phiphase/dsp_audio_filter/hardware/audio filter.xlsx

Sheet: BOM
Reference | Qty | Value | Supplier | Order code | Price ea. | QTY ordered | Total price | Ordered | Already got | Notes | Datasheet
A1 | 1 | TPS63060 Module | Pi hut | Adafruit Verta | £9.600 | 1 | £9.60 | Yes | No | Ada Fruit Module | https://www.adafruit.com/product/2190
A2 | 1 | RaspberryPi_Pico-2 | Pi hut |  |  |  |  |  | Yes | RPI Pico 2 module | https://datasheets.raspberrypi.com/pico/pico-datasheet.pdf
A3 | 1 | UDA1334A Module | Pi Hut |  |  |  |  |  | Yes | Ada Fruit Module | https://learn.adafruit.com/adafruit-i2s-stereo-decoder-uda1334a/downloads
A4 | 1 | PAM8302A module | Pi Hut |  | £3.800 | 1 | £3.80 | Yes | No | Ada Fruit Module | https://learn.adafruit.com/adafruit-pam8302-mono-2-5w-class-d-audio-amplifier/downloads
A5 | 1 | ADS1015 module | Pi Hut |  |  |  |  |  | Yes | Ada Fruit Module | https://learn.adafruit.com/adafruit-4-channel-adc-breakouts/downloads
BT1 | 1 | 9 V |  |  |  |  |  |  | Yes | Battery clip | ~
C1 | 1 | 10u |  |  |  |  |  |  | Yes |  | ~
C2,C3,C4,C5,C6,C7 | 6 | 1n |  |  |  |  |  |  | Yes |  | ~
D1,D2,D3 | 3 | 1N4001 |  |  |  |  |  |  | Yes |  | http://www.vishay.com/docs/88503/1n4001.pdf
D4,D5,D6 | 3 | LED |  |  |  |  |  |  | Yes | 3mm, 10 mA | ~
D7 | 1 | 1N4148 |  |  |  |  |  |  | Yes |  | https://www.diodes.com/assets/Datasheets/ds30396.pdf
FB1,FB2,FB3,FB4,FB5,FB6 | 6 | FerriteBead | Bowood Electronics | FRB102 | £0.180 | 10 | £1.80 | No | No |  | ~
J1 | 1 | Switchcraft 721A | Mouser | 502-721A | £3.000 | 2 | £6.00 | Yes | No | Chassis mount 5.5mm/2.1mm DC jack | https://www.mouser.co.uk/datasheet/2/393/721A_CD-2943197.pdf
J2, J3, J5 | 3 | Switchcraft 35RAPC2AV | Mouser | 502-35RAPC2AV | £1.850 | 3 | £5.55 | Yes | No | Chassis mount 3.5mm | https://www.mouser.co.uk/datasheet/2/393/35rapc2av_cd-2942933.pdf
J4, J6 | 1 | Switchcraft 35RAPC4BV4 | Mouser | 502-35RAPC4BV4 | £2.850 | 2 | £5.70 | Yes | No | Chassis mount 3.5 mm | https://www.mouser.co.uk/datasheet/2/393/35rapc__v4_cd-2942951.pdf
J7 | 1 | Switchcraft BPJF04AUX | Mouser | 502-BPJF04AUX | £1.730 | 4 | £6.92 | Yes | No | Chassis mount phono socket | https://www.mouser.co.uk/datasheet/2/393/bpjf_x_series_cd-2943146.pdf
J8 | 1 | Conn_01x03_Pin |  |  |  |  |  |  | Yes |  | ~
JP1 | 1 | short to select fc/BW mode |  |  |  |  |  |  | Yes |  | ~
R1,R2,R3,R4,R6,R7,R9,R11 | 8 | 10k |  |  |  |  |  |  | Yes | 0.125 W | ~
RV1,RV2,RV3, RV4 | 3 | 10k | Mouser | 858-P160KNP0QC20B10K (https://www.mouser.co.uk/ProductDetail/858-P091N-FC25BR10K) | £1.370 | 4 | £5.48 | Yes | No | Potentiometer | https://www.mouser.co.uk/datasheet/2/414/P09x-3235531.pdf
R5 | 1 | 560 |  |  |  |  |  |  | Yes |  | ~
R8,R10,R12 | 3 | 330 |  |  |  |  |  |  | Yes |  | ~
R13 | 1 | 100k |  |  |  |  |  |  | Yes
SW1,SW2,SW3,SW4,SW5,SW6 | 6 | SPST Sub-min toggle switch | Mouser | 737-SW-T3-1A-A-A3-S1 | £0.717 | 6 | £4.30 | Yes | No |  | https://www.mouser.co.uk/datasheet/2/4/sw_t3_1a_a_a3_s1_data_sheet-3396620.pdf
TP1,TP2,TP3,TP4,TP5,TP6,TP7,TP8,TP9,TP10,TP11,TP13 | 12 | TestPoint |  |  |  |  |  |  | Yes |  | ~
TR1 | 1 | BS170 | Mouser | 512-BS170 | £0.133 | 10 | £1.33 | Yes | No | TO-92 N-ch Enh. MOSFET | https://www.onsemi.com/products/discrete-power-modules/mosfets/small-signal-mosfets/bs170
TR2,TR3,TR4 | 3 | 2N2222 | Mouser | 637-2N2222A | £0.094 | 50 | £4.70 | Yes | No | TO92 | https://ngspice.sourceforge.io/docs/ngspice-html-manual/manual.xhtml#cha_BJTs
U5 | 1 | LM4040LP-3 | Mouser | 595-LM4040C30ILPR | £0.614 | 1 | £0.61 | Yes | No | TO92 3.0 V Ref. | http://www.ti.com/lit/ds/symlink/lm4040-n.pdf
Misc.
Veroboard | 1 |  |  |  |  |  |  |  | Yes
9 V PP3 Battery | 1 |  |  |  |  |  |  |  | Yes
Velcro coins for battery | 1 |  |  |  |  |  |  |  | No
Enclosure | 1 |  |  |  |  |  |  |  | No
Knobs for pots | 3 |  | Bowood Electronics | NOB160 | £0.500 | 3 | £1.50 | No | No
0.1 in. pin strip | 5 |  |  |  |  |  |  |  | No
Stick-on feet | 4 |  | RS Components | 276-9477 | £0.100 | 12 | £1.20 | Yes | No
6mm round spacer | 4 |  | RS Components | 606-759 | £7.850 | 1 | £7.85 | Yes | No | Pack of 50
M3 bolt | 4
M3 nut | 4
M3 Washer | 4

Sheet: Connections
Pin no. | J1 | J2 | J3 | J4 | J5 | J6 | J7 | J8 | J9 | J10 | J11 | J12
1 | R | KEY_OUT | GND | GND | GND | GND | AUDIO_IN | SPKR+ | 9V | HP_OUT | TUNE_LED_A | PWR_LED_A
2 | R | \TUNE | GND | SPKR_AMP_AUDIO_IN | \SPKR_ENA | KEY_OUT | GND | SPKR- | GND | GND | TUNE_LED_K | PWR_LED_K
3 | GND | R
4 | \FC_BW (GND) | R
5 | R
6 | \FILTER_IN
7 | \ALE_IN
8 | GND
9 | \AN
10 | KEY_IN
11 | DOT
12 | DASH
