phiphase/dsp_audio_filter/hardware/audio filter.kicad_sch

## KiCad design hardware/audio filter.kicad_sch (2025-12-23, an earlier design)

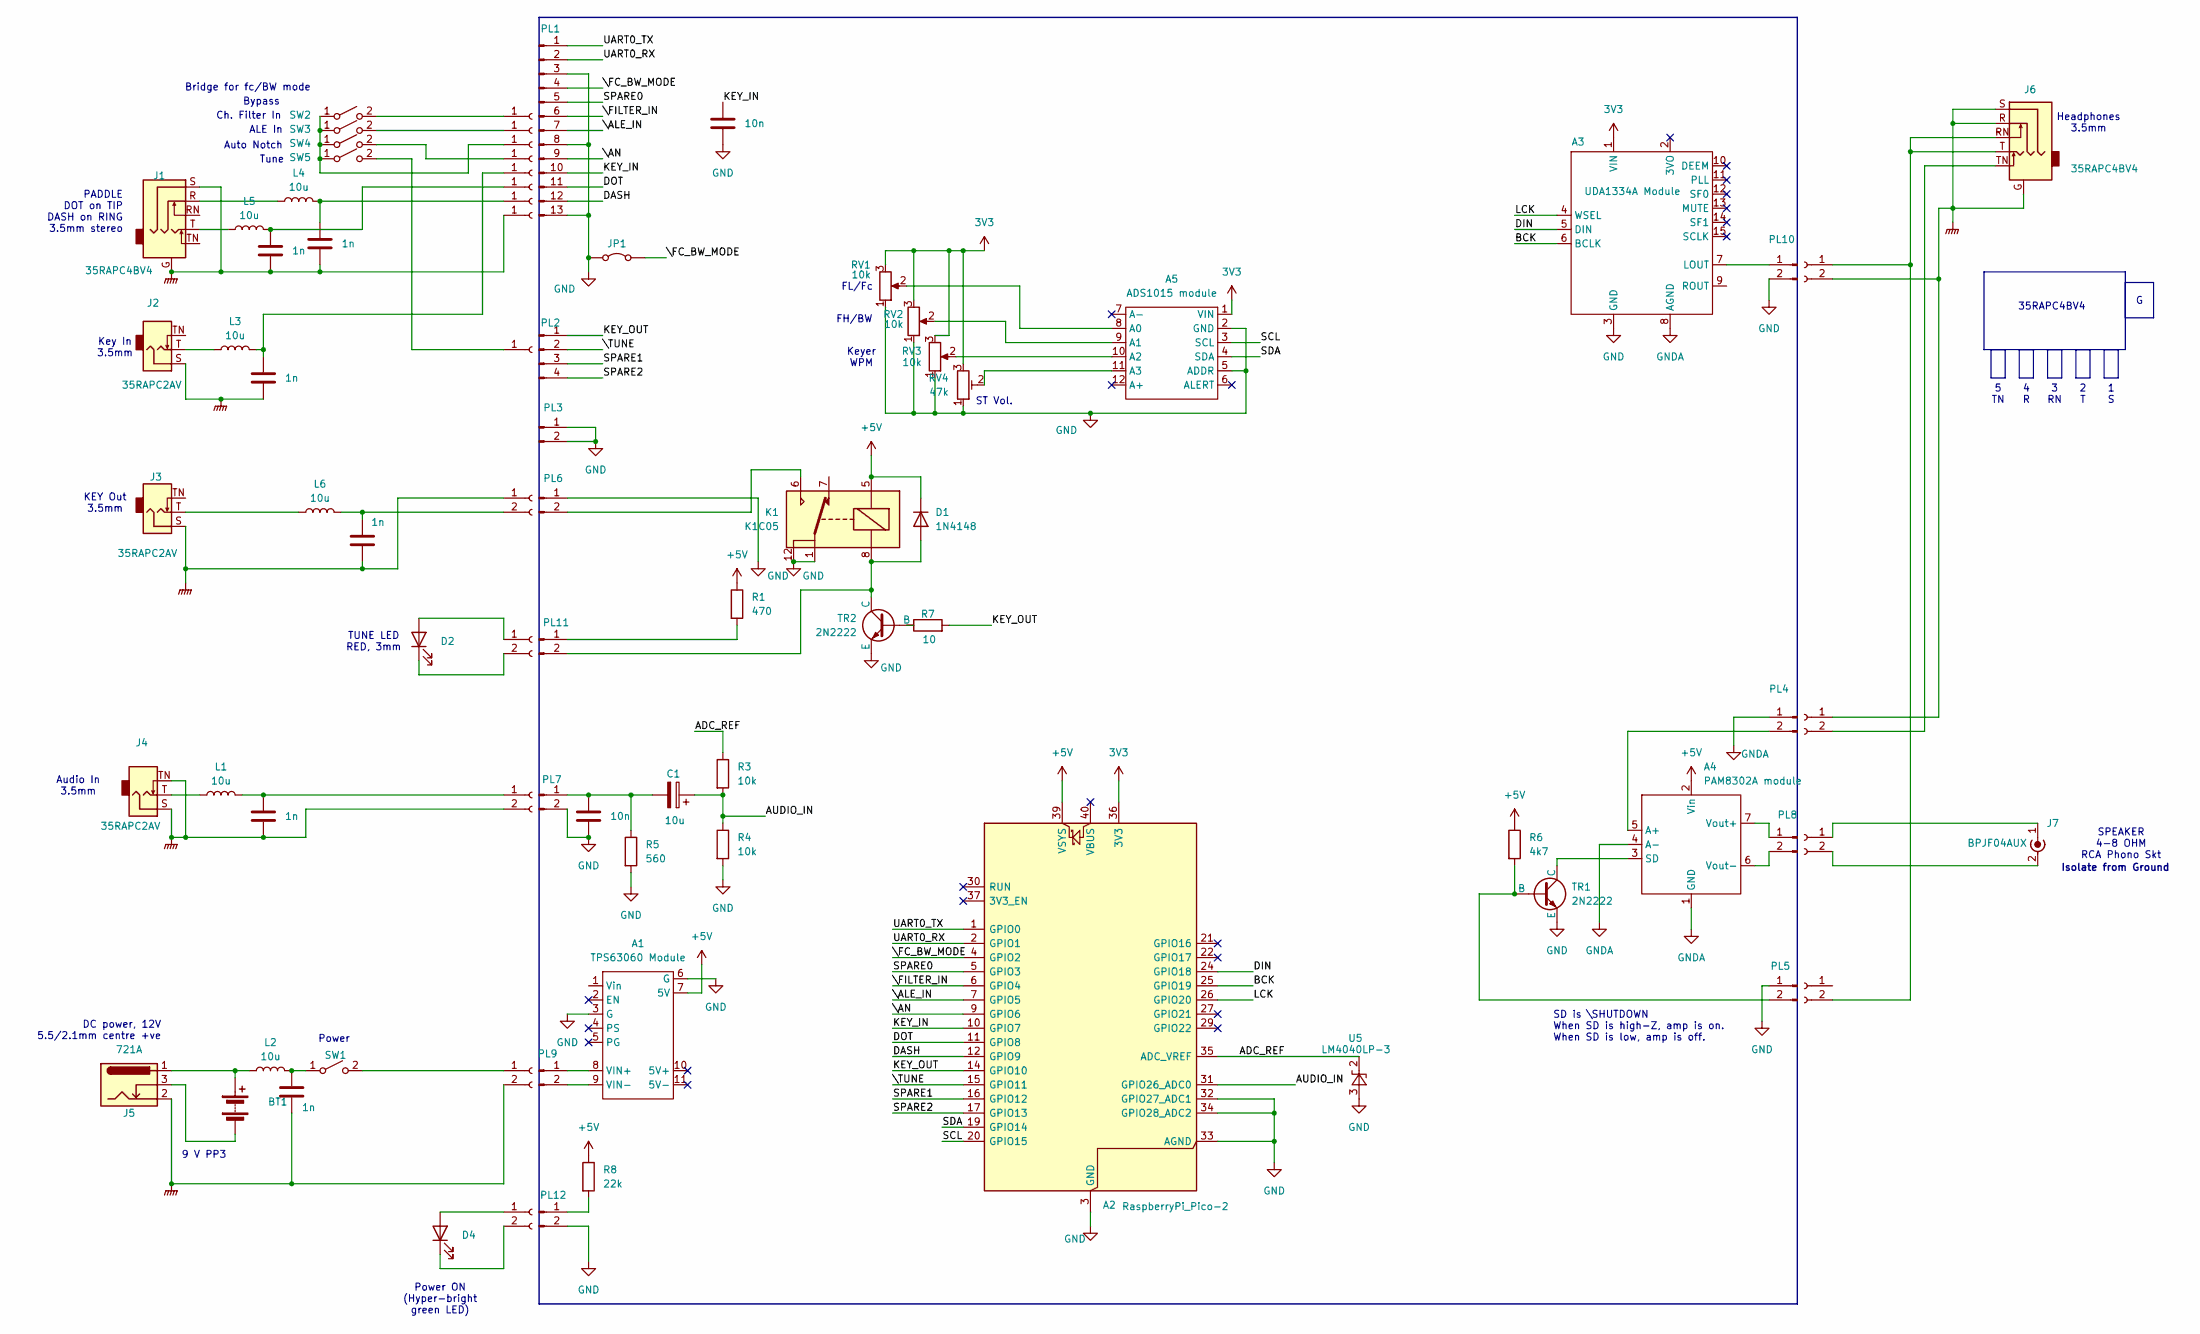
[picture p1: schematic audio filter.kicad_sch]

Parts:
A1: TPS63060 Module
A2: RaspberryPi_Pico-2; RaspberryPi_Pico_Common_Unspecified
A3: UDA1334A Module
A4: PAM8302A module
A5: ADS1015 module
BT1: 9 V
C1: 10u
C2, C3, C4, C5, C6, C7: 1n
C8, C9: 10n
D1: 1N4148; D_SOD-523
D2, D4: LED
J1, J6: 35RAPC4BV4
J2, J3, J4: 35RAPC2AV
J5: 721A
J7: BPJF04AUX
JP1: short to select fc/BW mode
K1: K1C05
L1, L2, L3, L4, L5, L6: 10u
PL1: Conn_01x13_Pin
PL2: Conn_01x04_Pin
PL3, PL4, PL5, PL6, PL7, PL8, PL9, PL10, PL11, PL12: Conn_01x02_Pin
R1: 470
R3, R4: 10k
R5: 560
R6: 4k7
R7: 10
R8: 22k
RV1, RV2, RV3: 10k
RV4: 47k
SK1a1, SK1b1, SK1c1, SK1d1, SK1e1, SK1f1, SK1g1, SK1h1, SK2a1: Conn_01x01_Socket
SK4, SK5, SK6, SK7, SK8, SK9, SK10, SK11, SK12: Conn_01x02_Socket
SW1, SW2, SW3, SW4, SW5: SW-T2-1C-A-A2-M1
TR1, TR2: 2N2222
U5: LM4040LP-3; TO-92_Inline

Connections:
3V3: A2.36 (3V3), A3.1 (VIN), A5.1 (VIN), RV1.3, RV2.3, RV3.3, RV4.3
+5V: A1.7 (5V), A2.39 (VSYS), A4.2 (Vin), D1.1 (K), K1.5, R1.1, R6.1, R8.1
ADC_REF: A2.35 (ADC_VREF), R3.1, U5.2 (K)
AUDIO_IN: A2.31 (GPIO26_ADC0), C1.1, R3.2, R4.1
BCK: A2.25 (GPIO19), A3.6 (BCLK)
DASH: A2.12 (GPIO9), PL1.12
DIN: A2.24 (GPIO18), A3.5 (DIN)
DOT: A2.11 (GPIO8), PL1.11
GND: A1.3 (G), A1.6 (G), A2.3 (GND), A2.8 (GND), A2.13 (GND), A2.18 (GND), A2.23 (GND), A2.28 (GND), A2.32 (GPIO27_ADC1), A2.33 (AGND), A2.34 (GPIO28_ADC2), A2.38 (GND), A3.3 (GND), A5.2 (GND), A5.5 (ADDR), C8.2, C9.2, JP1.1 (A), K1.1, K1.12, PL1.3, PL1.8, PL1.13, PL3.1, PL3.2, PL5.1, PL6.1, PL7.2, PL10.2, PL12.2, R4.2, R5.2, RV1.1, RV2.1, RV3.1, RV4.1, TR1.3 (E), TR2.3 (E), U5.3 (A)
GNDA: A3.8 (AGND), A4.1 (GND), A4.4 (A-), PL4.1
GNDPWR: C2.2, C3.2, C4.2, C5.2, C6.2, C7.2, J1.G, J1.S, J2.S, J3.S, J4.S, J4.TN, J5.2, J6.G, J6.R, J6.S, SK1h1.1, SK4.1, SK6.1, SK7.2, SK9.2, SK10.2
KEY_IN: A2.10 (GPIO7), C9.1, PL1.10
KEY_OUT: A2.14 (GPIO10), PL2.1, R7.2
LCK: A2.26 (GPIO20), A3.4 (WSEL)
unnamed: A1.8 (VIN+), PL9.1
unnamed: A1.9 (VIN-), PL9.2
unnamed: A3.7 (LOUT), PL10.1
unnamed: A4.3 (SD), TR1.1 (C)
unnamed: A4.5 (A+), PL4.2
unnamed: A4.6 (Vout-), PL8.2
unnamed: A4.7 (Vout+), PL8.1
unnamed: A5.8 (A0), RV1.2
unnamed: A5.9 (A1), RV2.2
unnamed: A5.10 (A2), RV3.2
unnamed: A5.11 (A3), RV4.2
unnamed: BT1.1 (+), J5.1, L2.1
unnamed: BT1.2 (-), J5.3
unnamed: C1.2, C8.1, PL7.1, R5.1
unnamed: C2.1, L2.2, SW1.1 (A)
unnamed: C3.1, L1.2, SK7.1
unnamed: C4.1, L3.2, SK1e1.1
unnamed: C5.1, L4.2, SK1g1.1
unnamed: C6.1, L5.2, SK1f1.1
unnamed: C7.1, L6.2, SK6.2
unnamed: D1.2 (A), K1.8, PL11.2, TR2.1 (C)
unnamed: D2.1 (K), SK11.2
unnamed: D2.2 (A), SK11.1
unnamed: D4.1 (K), SK12.2
unnamed: D4.2 (A), SK12.1
unnamed: J1.R, L4.1
unnamed: J1.T, L5.1
unnamed: J2.T, L3.1
unnamed: J3.T, L6.1
unnamed: J4.T, L1.1
unnamed: J6.RN, J6.T, SK5.2, SK10.1
unnamed: J6.TN, SK4.2
unnamed: J7.1 (In), SK8.1
unnamed: J7.2 (Ext), SK8.2
unnamed: K1.6, PL6.2
unnamed: PL5.2, R6.2, TR1.2 (B)
unnamed: PL11.1, R1.2
unnamed: PL12.1, R8.2
unnamed: R7.1, TR2.2 (B)
unnamed: SK1a1.1, SW2.2 (B)
unnamed: SK1b1.1, SW3.2 (B)
unnamed: SK1c1.1, SW2.1 (A), SW3.1 (A), SW4.1 (A), SW5.1 (A)
unnamed: SK1d1.1, SW4.2 (B)
unnamed: SK2a1.1, SW5.2 (B)
unnamed: SK9.1, SW1.2 (B)
SCL: A2.20 (GPIO15), A5.3 (SCL)
SDA: A2.19 (GPIO14), A5.4 (SDA)
SPARE0: A2.5 (GPIO3), PL1.5
SPARE1: A2.16 (GPIO12), PL2.3
SPARE2: A2.17 (GPIO13), PL2.4
UART0_RX: A2.2 (GPIO1), PL1.2
UART0_TX: A2.1 (GPIO0), PL1.1
\ALE_IN: A2.7 (GPIO5), PL1.7
\AN: A2.9 (GPIO6), PL1.9
\FC_BW_MODE: A2.4 (GPIO2), JP1.2 (B), PL1.4
\FILTER_IN: A2.6 (GPIO4), PL1.6
\TUNE: A2.15 (GPIO11), PL2.2

Notes on the sheet:
9 V PP3
Ch. Filter In
Auto Notch
Isolate from Ground
Bypass
SD is \SHUTDOWN When SD is high-Z, amp is on. When SD is low, amp is off.
Tune
1 S
5 TN
3 RN
SPEAKER 4-8 OHM RCA Phono Skt
FL/Fc
Key In 3.5mm
35RAPC4BV4
KEY Out 3.5mm
TUNE LED RED, 3mm
Bridge for fc/BW mode
PADDLE DOT on TIP DASH on RING 3.5mm stereo
ALE In
Keyer WPM
4 R
Audio In 3.5mm
Headphones 3.5mm
ST Vol.
FH/BW
Power
2 T
DC power, 12V 5.5/2.1mm centre +ve
Power ON (Hyper-bright green LED)
