phiphase/dsp_audio_filter/software/cw.h

/*
  ******************************************************************************
  * Copyright (C) 2025 Adrian P. Nash, G4ZHZ, github/phiphase
  * File:    cw.h
  * Description:
  * Definitions for the CW/side-tone functions
  *****************************************************************************
  */
 #ifndef __CW_H__
 #define __CW_H__

#include "arm_math.h"
#include <math.h>
#ifndef M_PI
#define M_PI 3.1415926535897932384626433832
#endif

#define Q15

#ifdef Q15
#define NUM_CW_FILTER_COEFFS 6
typedef struct
{
  float32_t dphi; // delta-phi to provide the side-tone frequency
  uint64_t n;     // The sample number
  arm_biquad_casd_df1_inst_q15 filterObj;
  q15_t coeffs[NUM_CW_FILTER_COEFFS];
  q15_t state[4];
} cw_gen_obj;


void init_cw(cw_gen_obj *obj, float32_t fs, float32_t fst);
void gen_cw(cw_gen_obj *obj, q15_t * input, q15_t *output, float32_t amp, uint32_t numSamples);

#else
#define NUM_CW_FILTER_COEFFS 5
typedef struct
{
  float32_t dphi; // delta-phi to provide the side-tone frequency
  uint64_t n;     // The sample number
  arm_biquad_casd_df1_inst_f32 filterObj;
  float32_t coeffs[NUM_CW_FILTER_COEFFS];
  float32_t state[4]; 
} cw_gen_obj;

void init_cw(cw_gen_obj *obj, float32_t fs, float32_t fst);
void gen_cw(cw_gen_obj *obj, q15_t * input, q15_t *output, float32_t amp, uint32_t numSamples);

#endif //Q15

#endif
