phiphase/dsp_audio_filter/(commit log)

2025-07-13 Added I2S DMA to drive the PIO.
2025-07-16 I2S PIO now working via DMA and DMA interrupt handler. Merged hello.c into dsp_audio_filter and hello.pio into i2s.pio.
2025-07-21 ADC and I2S use two DMA channels each to effectively access two buffers so that we can do pint-pong buffering. Two DMA ISRs are provided. IRQ0 is for the ADC DMA and IRQ1 is for the I2S DMA.
2025-07-22 Using the ADC interrupt and adc_semaphore, the ping-pong buffer management appears to work.
2025-07-24 Changed the PIO clock division to be fractional using the sm_config_set_clkdiv_int_frac8() function. This enables an exact 8ksps to be used for I2S.
    Changed the ring buffer size from 9 to 8 bits for
    the ADC and 10 to 9 bits for the I2S.
    The ADC output is now left-shifted by 3 bits so
    that it aligns with 16 bit 2's complement.
2025-07-26 Added support for the ARM CMSIS library.
2025-07-26 Added Kaiser window filtering functions to dynamicFilters.c and dynamicFilters.h. Modified dsp_audio_filter.c so that core 1 generates the coefficients so that they can be verified in MATLAB.
2025-07-27 filter.c and filter.h added. The ARM CMSIS-DSP filter has been added to filter the channel. Inter-processor communication added that uses the hardware FIFO to send commands from core-1 to core-0 and 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
2025-08-03 Added the ADS1015 ADC driver functionality.
2025-08-03 ADC now connected to the channel filter so the ADC channel 0 controls the HPF cut-off frequency and ADC channel 1 controls the LPF cut-off frequency.
2025-08-03 Added GPIO2 fc/bw mode set. When GPIO2 is pulled low, fc/bw for ADC 0/1 is set. When GPIO2 is left floating (pulled up), fL/fH for ADC 0/1 is selected.
2025-08-09 ALE now working. Moved all CMSIS filter variables into global space so that the spin-locks work correctly.
    [dsp_audio_filter.c]
2025-08-10 Added the GPIO edge-sensitive interrupt handler and got the profiler option working correctly.
    [dsp_audio_filter.c]
2025-08-13 Got the Imbic electronic keyer working. Added ADC-controlled keyer speed. Added ADC-controlled volume control but need to make this logarithmic.
2025-08-15 Added a volume control on adc[3]. However, this is not needed because we can use the Rx volume control, so it will be removed.
2025-08-15 Added a type I Bi-quad IIR filter to cw generator.
2025-09-28 Added the KiCad hardware files
    [audio filter.csv, audio filter.kicad_pcb, audio filter.kicad_sch, audio filter.xlsx]
2025-09-28 Updated from audio filter bom v2
    [audio filter.xlsx]
2025-10-04 Changed B_MIN and B_MAX to 0 Hz and 2000 Hz repectively. Changed FC_MIN and FC_MAX to 0 Hz and 2000 Hz respectively.
2025-10-04 DSP Audio Filter artwork for Gekko rub-down Deccal paper. Print the User-2 layer.
    [panel-art.kicad_pcb]
2025-10-04 DSP Audio Filter front and rear panel drawings. Use as a template for drilling the panels. paper. Print the User-drawings, User-3 and User-4 layers.
    [panel-drg.kicad_pcb]
2025-10-04 Moved the KEY LED position.
    [panel-drg.kicad_pcb]
2025-10-04 Moved the location of the KEY LED text. Changed radius of knobs to 5.5mm.
    [panel-art.kicad_pcb]
2025-10-14 Version 0.3 RE-arranged circuit into external connections and on-board headers. Changed FBs to 10uH inductors.
    [audio filter.kicad_sch]
2025-10-14 Added board layout page.
    [audio filter.xlsx, panel-art.kicad_pcb]
2025-10-15 Revise README with updated audio filter specs
    Added photographs.
2025-10-15 Correct 'centre frequency' to 'centre frequency'
    Changed bandwidth range to 0-2000 Hz.
2025-10-15 Update README.md
    Added, "The loud speaker makes a hell of a lot of RFI. Being Class-it relies on the high frequency PWM switching to operate. A subsequent revision won't use it. Use headphones."
2025-10-15 Revision A (Prototype).
    [audio filter.kicad_pcb, audio filter.kicad_sch]
2025-11-04 Added 1n C10/C11 to SPKR output to filter out RF. Started modle footprint library.
    [audio filter.kicad_sch]
2025-11-04 Modified ADC range to suit potentiometers and zipped up the build files into dsp_audio_filter_build.zip.
2025-12-23 Removed the 10uH choke from Key out.
    [audio filter.kicad_sch]
